andrewcchen/blu64/schematics.pdf

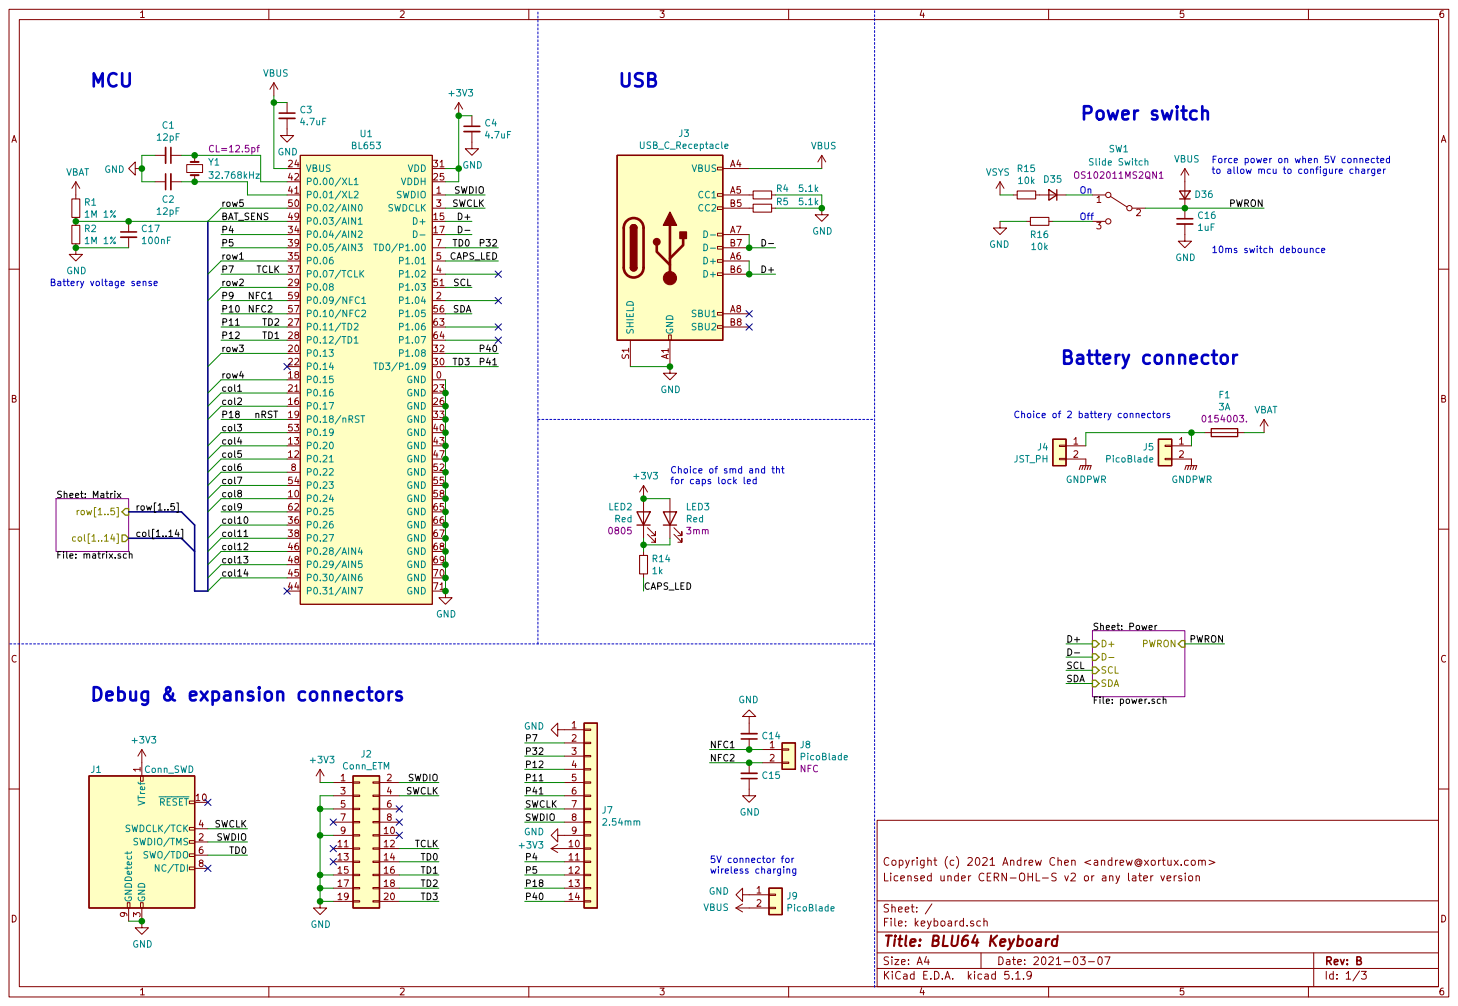
[picture p1: page 1]

to allow mcu to configure charger 10ms switch debounce Power switch

Force power on when 5V connected

SCL SDA
5V connector for wireless charging Choice of smd and tht

for caps lock led

Sheet: Matrix File: matrix.sch
row[1..5]

3 SWDCLK/TCK 4 SWO/TDO 6 NC/TDI 8 GNDDetect 9

Copyright (c) 2021 Andrew Chen <andrew@xortux.com>
File: keyboard.sch Sheet: / Licensed under CERN-OHL-S v2 or any later version

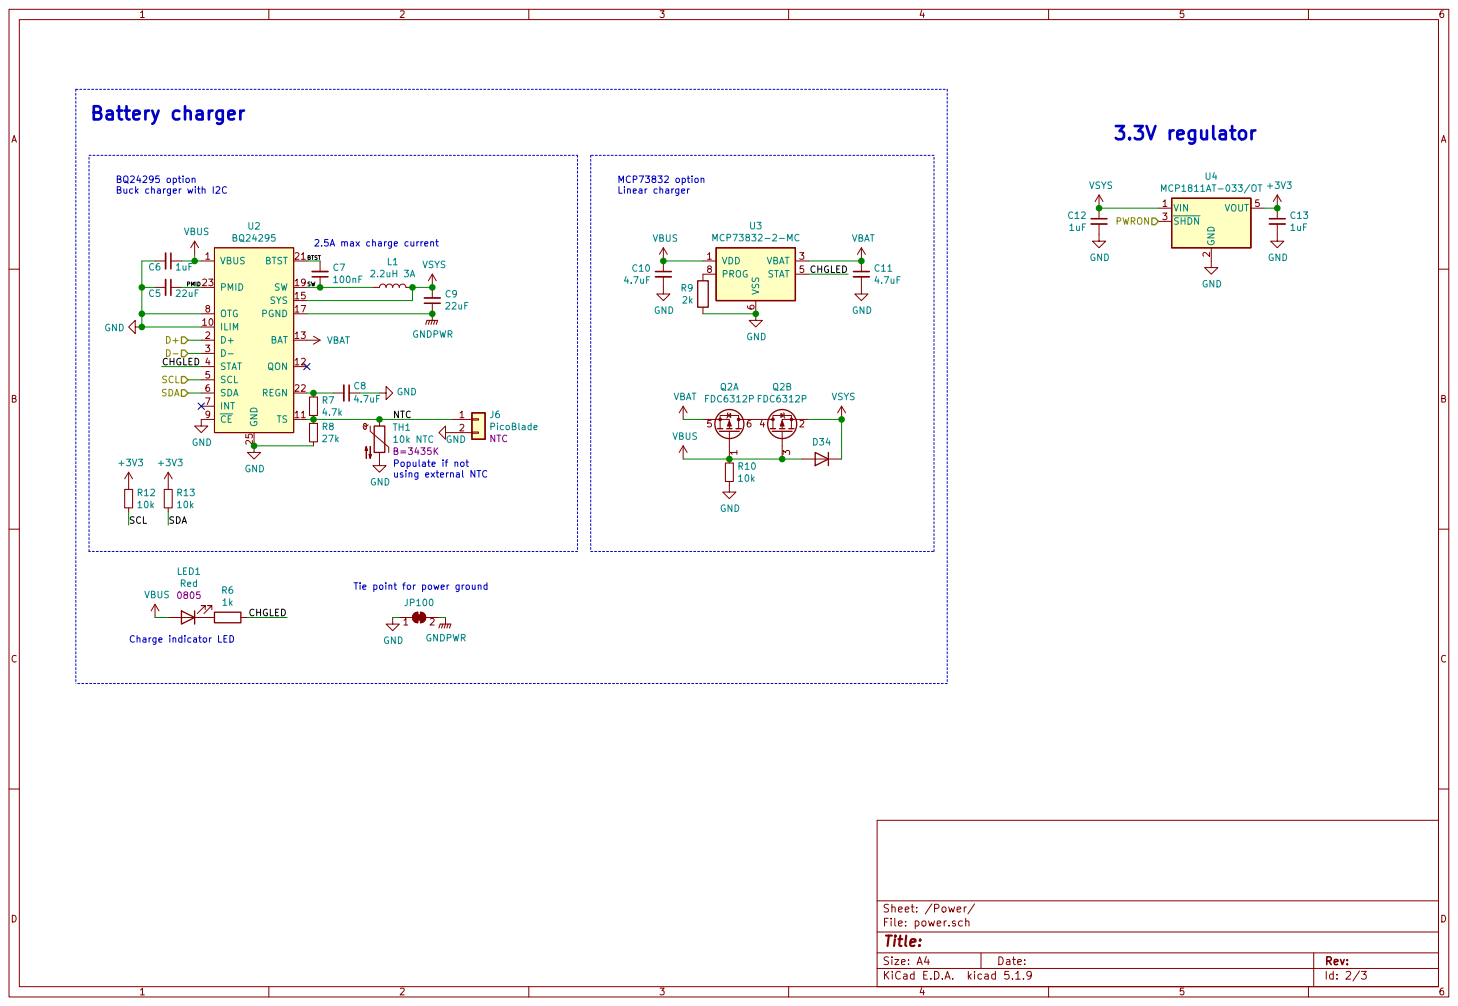
[picture p2: page 2]

Tie point for power ground

File: power.sch Sheet: /Power/
Id: 2/3 Title:

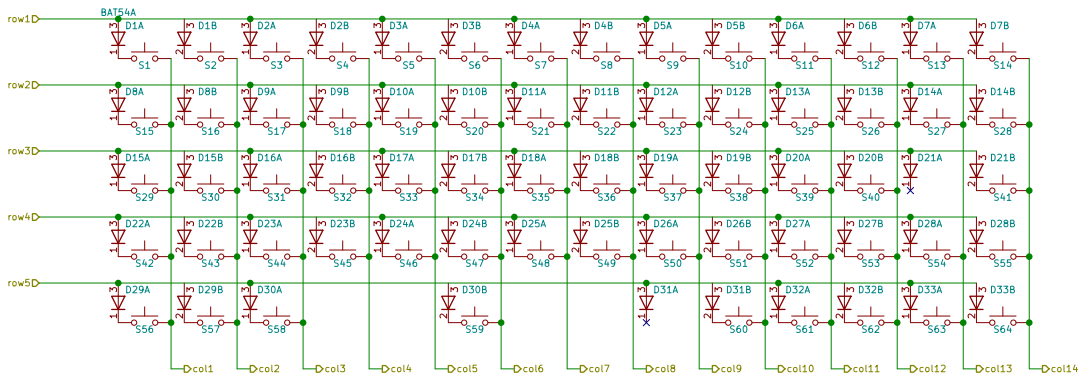
[picture p3: page 3]

Id: 3/3 Title: File: matrix.sch Sheet: /Matrix/
