andrewcchen/blu64/keyboard.kicad_pcb

## KiCad design keyboard.kicad_pcb (2021-03-07)

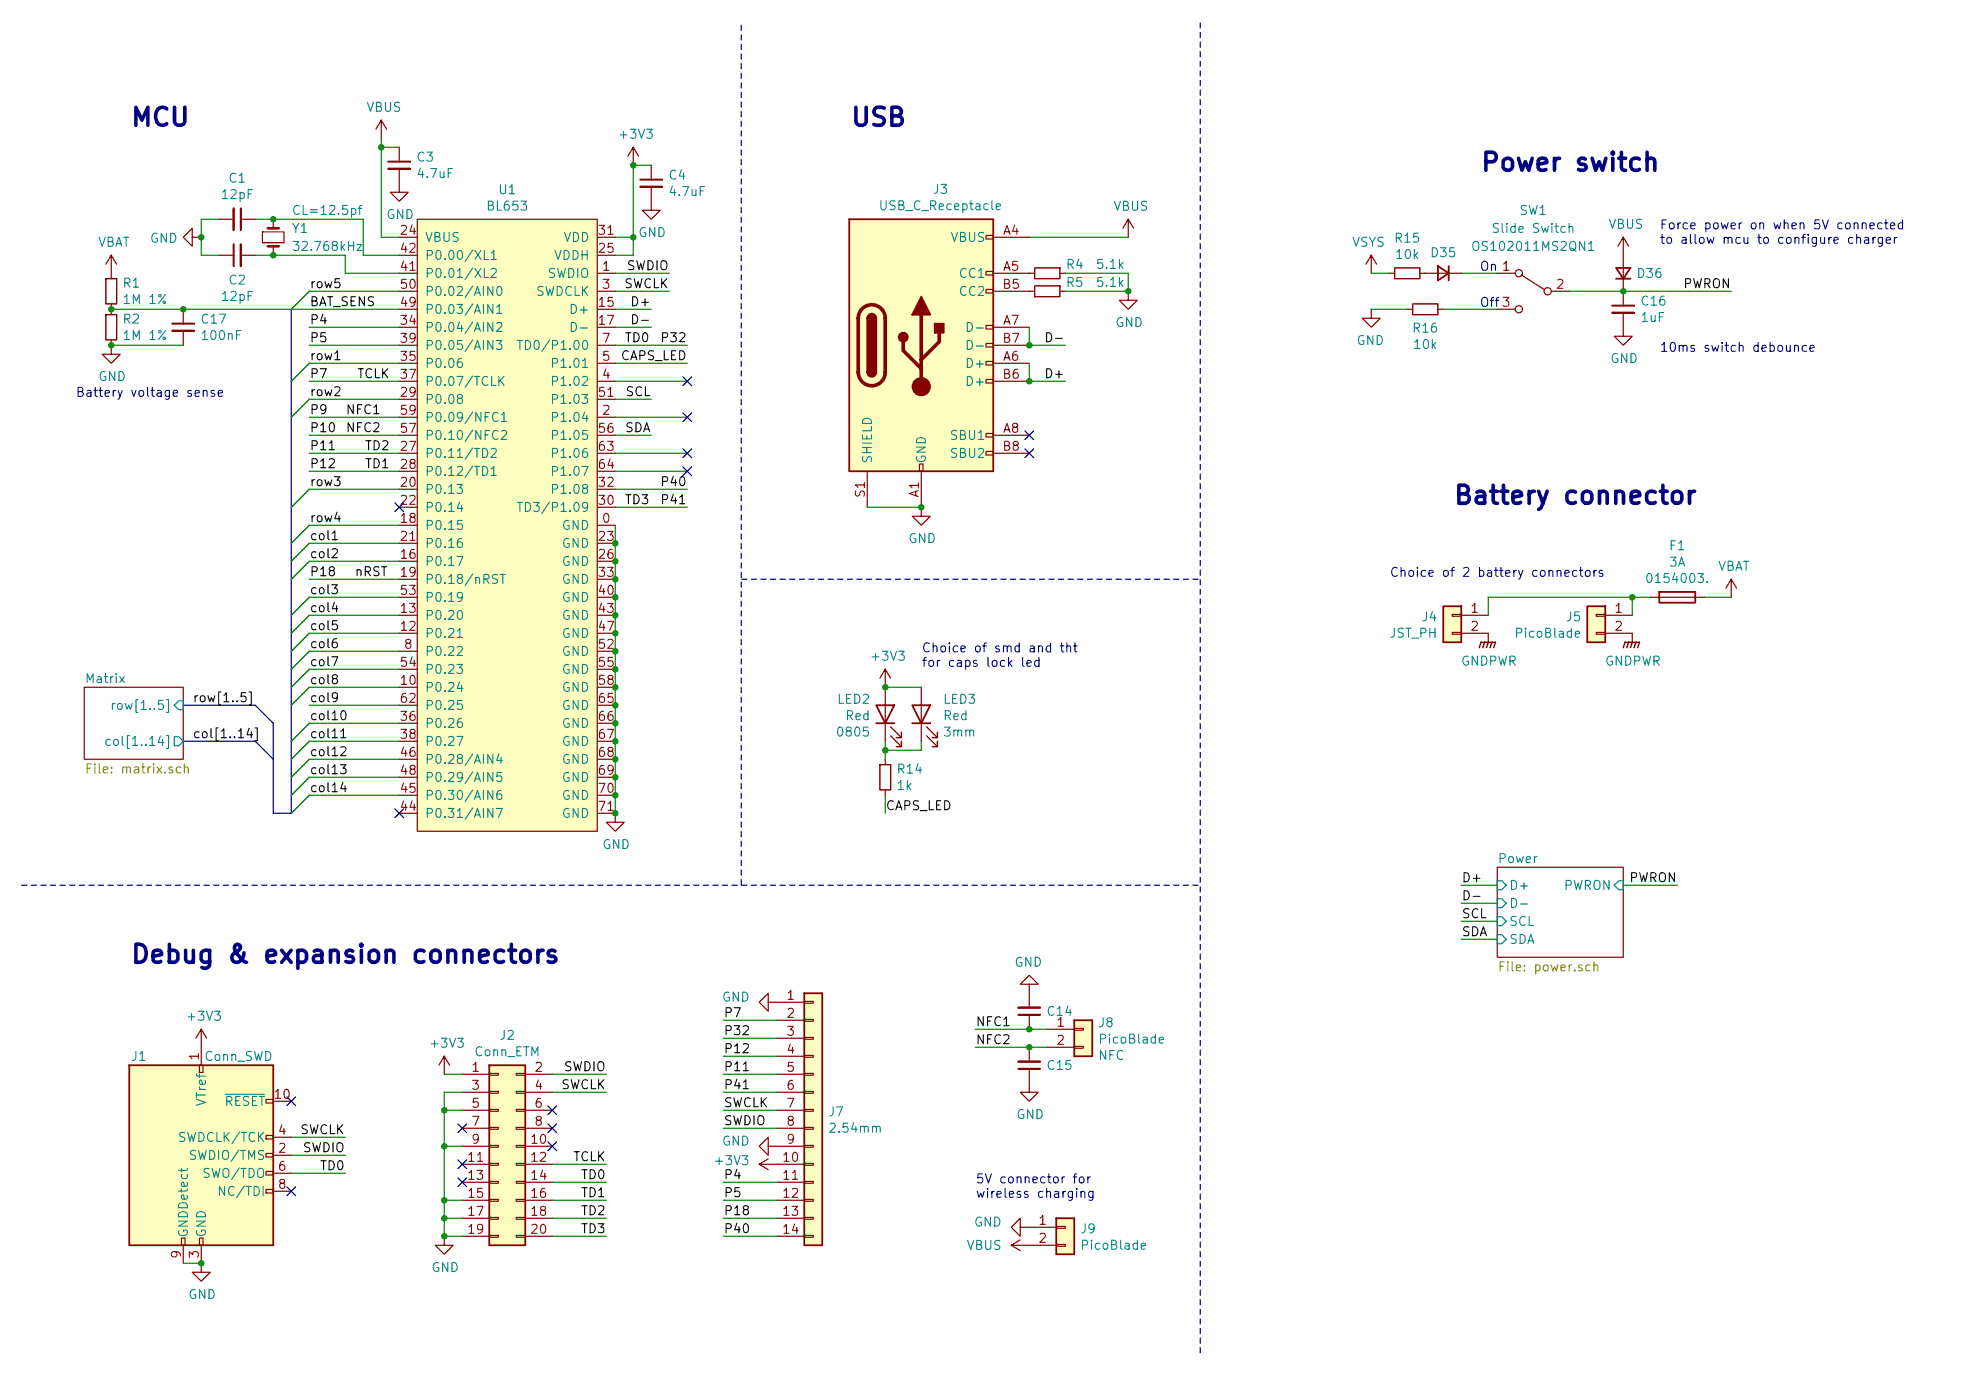
[picture p4: schematic keyboard.sch, BLU64 Keyboard]

Parts:
C1, C2: 12pF; C_0805_2012Metric
C3, C4: 4.7uF; C_0805_2012Metric
C14, C15: Ctune; C_0805_2012Metric
C16: 1uF; C_0805_2012Metric
C17: 100nF; C_0805_2012Metric
D35, D36: 1N4007; D_SOD-123; Part SOD-123 1N4007
F1: 3A; Fuseholder_Littelfuse_Nano2_154x; Part 0154003.
J1: Conn_SWD; PinHeader_2x05_P1.27mm_Vertical_SMD; Part FTSH-105-01-L-DV-K
J2: Conn_ETM; PinHeader_2x10_P1.27mm_Vertical_SMD; Part FTSH-110-01-L-DV-K
J3: USB_C_Receptacle; USB_C_Receptacle_HRO_TYPE-C-31-M-12; Part TYPE-C-31-M-12
J4: JST_PH; JST_PH_S2B-PH-SM4-TB_1x02-1MP_P2.00mm_Horizontal; Part S2B-PH-SM4-TB
J5, J8, J9: PicoBlade; Molex_PicoBlade_53261-0271_1x02-1MP_P1.25mm_Horizontal; Part 53261-0271
J7: 2.54mm; PinHeader_1x14_P2.54mm_Vertical
LED2: Red; LED_0805_2012Metric
LED3: Red; LED_D3.0mm
R1, R2: 1M 1%; R_0805_2012Metric
R4, R5: 5.1k; R_0805_2012Metric
R14: 1k; R_0805_2012Metric
R15, R16: 10k; R_0805_2012Metric
SW1: Slide Switch; SW_OS102011MS2QN1; Part OS102011MS2QN1
U1: BL653; Laird_BL653; Part 453-00039
Y1: 32.768kHz; Crystal_SMD_3215-2Pin_3.2x1.5mm

Connections:
+3V3: C4.1, J1.1 (VTref), J2.1, J7.10, LED2.2 (A), LED3.2 (A), U1.25 (VDDH), U1.31 (VDD); also elsewhere on the board
/BAT_SENS: C17.1, R1.2, R2.1, U1.49 (P0.03/AIN1)
/CAPS_LED: R14.2, U1.5 (P1.01)
/D+: J3.A6 (D+), J3.B6 (D+), U1.15 (D+); also elsewhere on the board
/D-: J3.A7 (D-), J3.B7 (D-), U1.17 (D-); also elsewhere on the board
/NFC1: C14.1, J8.1, U1.59 (P0.09/NFC1)
/NFC2: C15.2, J8.2, U1.57 (P0.10/NFC2)
/P4: J7.11, U1.34 (P0.04/AIN2)
/P5: J7.12, U1.39 (P0.05/AIN3)
/P7: J2.12, J7.2, U1.37 (P0.07/TCLK)
/P11: J2.18, J7.5, U1.27 (P0.11/TD2)
/P12: J2.16, J7.4, U1.28 (P0.12/TD1)
/P18: J7.13, U1.19 (P0.18/nRST)
/P32: J1.6 (SWO/TDO), J2.14, J7.3, U1.7 (TD0/P1.00)
/P40: J7.14, U1.32 (P1.08)
/P41: J2.20, J7.6, U1.30 (TD3/P1.09)
/PWRON: C16.1, D36.1 (K), SW1.2 (B); also elsewhere on the board
/SCL: U1.51 (P1.03); also elsewhere on the board
/SDA: U1.56 (P1.05); also elsewhere on the board
/SWCLK: J1.4 (SWDCLK/TCK), J2.4, J7.7, U1.3 (SWDCLK)
/SWDIO: J1.2 (SWDIO/TMS), J2.2, J7.8, U1.1 (SWDIO)
/col1: U1.21 (P0.16); also elsewhere on the board
/col2: U1.16 (P0.17); also elsewhere on the board
/col3: U1.53 (P0.19); also elsewhere on the board
/col4: U1.13 (P0.20); also elsewhere on the board
/col5: U1.12 (P0.21); also elsewhere on the board
/col6: U1.8 (P0.22); also elsewhere on the board
/col7: U1.54 (P0.23); also elsewhere on the board
/col8: U1.10 (P0.24); also elsewhere on the board
/col9: U1.62 (P0.25); also elsewhere on the board
/col10: U1.36 (P0.26); also elsewhere on the board
/col11: U1.38 (P0.27); also elsewhere on the board
/col12: U1.46 (P0.28/AIN4); also elsewhere on the board
/col13: U1.48 (P0.29/AIN5); also elsewhere on the board
/col14: U1.45 (P0.30/AIN6); also elsewhere on the board
/row1: U1.35 (P0.06); also elsewhere on the board
/row2: U1.29 (P0.08); also elsewhere on the board
/row3: U1.20 (P0.13); also elsewhere on the board
/row4: U1.18 (P0.15); also elsewhere on the board
/row5: U1.50 (P0.02/AIN0); also elsewhere on the board
GND: C1.2, C2.1, C3.2, C4.2, C14.2, C15.1, C16.2, C17.2, J1.3 (GND), J1.5 (GND), J1.9 (GNDDetect), J2.3, J2.5, J2.9, J2.15, J2.17, J2.19, J3.A1 (GND), J3.A12 (GND), J3.B1 (GND), J3.B12 (GND), J3.S1 (SHIELD), J7.1, J7.9, J9.1, R2.2, R4.1, R5.1, R16.1, U1.0 (GND), U1.23 (GND), U1.26 (GND), U1.33 (GND), U1.40 (GND), U1.43 (GND), U1.47 (GND), U1.52 (GND), U1.55 (GND), U1.58 (GND), U1.65 (GND), U1.66 (GND), U1.67 (GND), U1.68 (GND), U1.69 (GND), U1.70 (GND), U1.71 (GND); also elsewhere on the board
GNDPWR: J4.2, J5.2; also elsewhere on the board
unnamed: C1.1, U1.42 (P0.00/XL1), Y1.1
unnamed: C2.2, U1.41 (P0.01/XL2), Y1.2
unnamed: D35.1 (K), SW1.1 (A)
unnamed: D35.2 (A), R15.2
unnamed: F1.2, J4.1, J5.1
unnamed: J3.A5 (CC1), R4.2
unnamed: J3.B5 (CC2), R5.2
unnamed: LED2.1 (K), LED3.1 (K), R14.1
unnamed: R16.2, SW1.3 (C)
VBAT: F1.1, R1.1; also elsewhere on the board
VBUS: C3.1, D36.2 (A), J3.A4 (VBUS), J3.A9 (VBUS), J3.B4 (VBUS), J3.B9 (VBUS), J9.2, U1.24 (VBUS); also elsewhere on the board
VSYS: R15.1; also elsewhere on the board

Notes on the sheet:
MCU
Debug & expansion connectors
USB
5V connector for wireless charging
Battery voltage sense
Choice of smd and tht for caps lock led
Force power on when 5V connected to allow mcu to configure charger
10ms switch debounce
Off
Choice of 2 battery connectors
Power switch
Battery connector

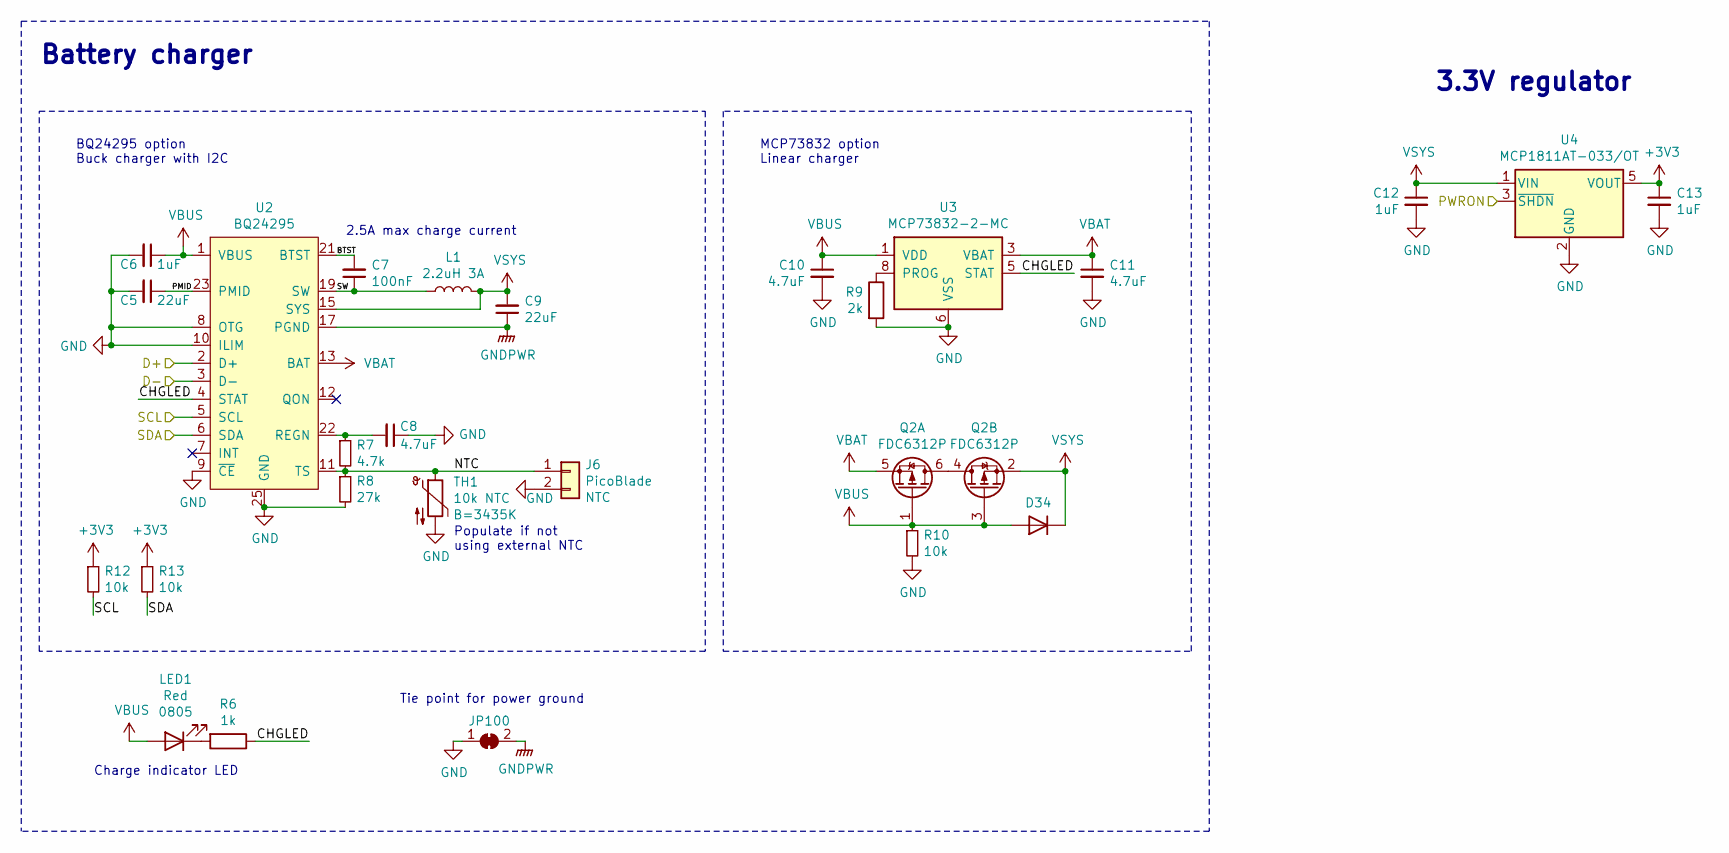
[picture p5: schematic power.sch]

Parts:
C5, C12, C13: 1uF; C_0805_2012Metric
C6, C9: 22uF; C_1206_3216Metric
C7: 100nF; C_0805_2012Metric
C8, C10, C11: 4.7uF; C_0805_2012Metric
D34: 1N4007; D_SOD-123; Part SOD-123 1N4007
J6: PicoBlade; Molex_PicoBlade_53261-0271_1x02-1MP_P1.25mm_Horizontal; Part 53261-0271
JP100: Jumper_2_Bridged; GND_Tie
L1: 2.2uH 3A; L_Bourns-SRN4018; Part BCIHP0420TB-2R2M
LED1: Red; LED_0805_2012Metric
Q2: FDC6312P; SuperSOT-6; Part FDC6312P
R6: 1k; R_0805_2012Metric
R7: 4.7k; R_0805_2012Metric
R8: 27k; R_0805_2012Metric
R9: 2k; R_0805_2012Metric
R10, R12, R13: 10k; R_0805_2012Metric
TH1: 10k NTC; R_0805_2012Metric
U2: BQ24295; QFN-24-1EP_4x4mm_P0.5mm_EP2.65x2.65mm; Part BQ24295
U3: MCP73832-2-MC; DFN-8-1EP_3x2mm_P0.5mm_EP1.7x1.4mm; Part MCP73832-2ACI/MC
U4: MCP1811AT-033/OT; SOT-23-5; Part MCP1811AT-033/OT

Connections:
+3V3: C13.1, R12.1, R13.1, U4.5 (VOUT); also elsewhere on the board
/D+: U2.2 (D+); also elsewhere on the board
/D-: U2.3 (D-); also elsewhere on the board
/PWRON: U4.3 (~SHDN); also elsewhere on the board
/Power/BTST: C7.2, U2.21 (BTST)
/Power/CHGLED: R6.1, U2.4 (STAT), U3.5 (STAT)
/Power/NTC: J6.1, R7.2, R8.1, TH1.1, U2.11 (TS)
/Power/PMID: C6.1, U2.23 (PMID)
/Power/SW: C7.1, L1.1, U2.19 (SW), U2.20 (SW)
/SCL: R12.2, U2.5 (SCL); also elsewhere on the board
/SDA: R13.2, U2.6 (SDA); also elsewhere on the board
GND: C5.2, C6.2, C8.1, C10.2, C11.2, C12.2, C13.2, J6.2, JP100.1 (A), R8.2, R9.2, R10.2, TH1.2, U2.8 (OTG), U2.9 (~CE), U2.10 (ILIM), U2.25 (GND), U3.6 (VSS), U3.9 (VSS), U4.2 (GND); also elsewhere on the board
GNDPWR: C9.1, JP100.2 (B), U2.17 (PGND), U2.18 (PGND); also elsewhere on the board
unnamed: C8.2, R7.1, U2.22 (REGN)
unnamed: LED1.1 (K), R6.2
unnamed: Q2.4 (D), Q2.6 (D)
unnamed: R9.1, U3.8 (PROG)
VBAT: C11.1, Q2.5 (S), U2.13 (BAT), U2.14 (BAT), U3.3 (VBAT), U3.4 (VBAT); also elsewhere on the board
VBUS: C5.1, C10.1, D34.2 (A), LED1.2 (A), Q2.1 (G), Q2.3 (G), R10.1, U2.1 (VBUS), U2.24 (VBUS), U3.1 (VDD), U3.2 (VDD); also elsewhere on the board
VSYS: C9.2, C12.1, D34.1 (K), L1.2, Q2.2 (S), U2.15 (SYS), U2.16 (SYS), U4.1 (VIN); also elsewhere on the board

Notes on the sheet:
2.5A max charge current
Populate if not using external NTC
BQ24295 option Buck charger with I2C
MCP73832 option Linear charger
Charge indicator LED
Battery charger
Tie point for power ground
3.3V regulator

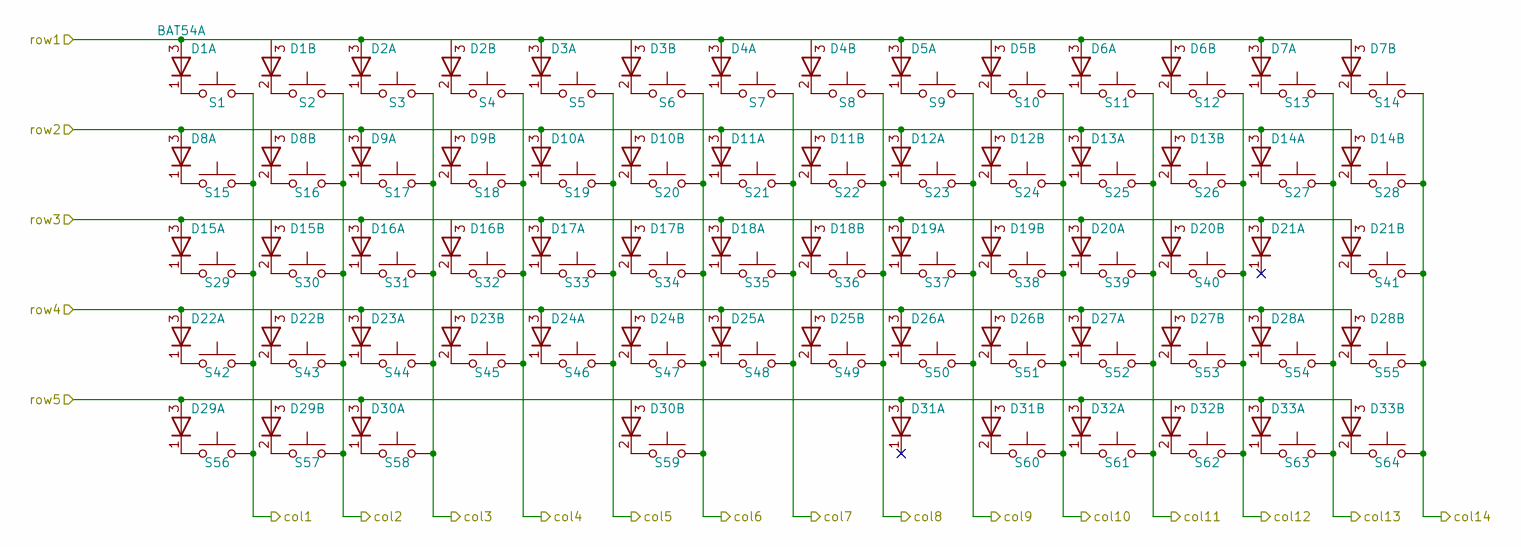
[picture p6: schematic matrix.sch]

Parts:
D1, D2, D3, D4, D5, D6, D7, D8, D9, D10, D11, D12, D13, D14, D15, D16, D17, D18, D19, D20, D21, D22, D23, D24, D25, D26, D27, D28, D29, D30, D31, D32, D33: BAT54A; SOT-23; Part BAT54A
S1, S2, S3, S4, S5, S6, S7, S8, S9, S10, S11, S12, S13, S16, S17, S18, S19, S20, S21, S22, S23, S24, S25, S26, S27, S30, S31, S32, S33, S34, S35, S36, S37, S38, S39, S40, S43, S44, S45, S46, S47, S48, S49, S50, S51, S52, S53, S54, S55, S60, S61, S62, S63, S64: MX1A; SW_Cherry_MX_1.00u_PCB
S14, S42: MX1A; SW_Cherry_MX_2.00u_PCB
S15, S28: MX1A; SW_Cherry_MX_1.50u_PCB
S29: MX1A; SW_Cherry_MX_1.75u_PCB
S41: MX1A; SW_Cherry_MX_2.25u_PCB
S56, S57, S58: MX1A; SW_Cherry_MX_1.25u_PCB
S59: MX1A; SW_Cherry_MX_6.25u_PCB

Connections:
/col1: S1.2, S15.2, S29.2, S42.2, S56.2; also elsewhere on the board
/col2: S2.2, S16.2, S30.2, S43.2, S57.2; also elsewhere on the board
/col3: S3.2, S17.2, S31.2, S44.2, S58.2; also elsewhere on the board
/col4: S4.2, S18.2, S32.2, S45.2; also elsewhere on the board
/col5: S5.2, S19.2, S33.2, S46.2; also elsewhere on the board
/col6: S6.2, S20.2, S34.2, S47.2, S59.2; also elsewhere on the board
/col7: S7.2, S21.2, S35.2, S48.2; also elsewhere on the board
/col8: S8.2, S22.2, S36.2, S49.2; also elsewhere on the board
/col9: S9.2, S23.2, S37.2, S50.2; also elsewhere on the board
/col10: S10.2, S24.2, S38.2, S51.2, S60.2; also elsewhere on the board
/col11: S11.2, S25.2, S39.2, S52.2, S61.2; also elsewhere on the board
/col12: S12.2, S26.2, S40.2, S53.2, S62.2; also elsewhere on the board
/col13: S13.2, S27.2, S54.2, S63.2; also elsewhere on the board
/col14: S14.2, S28.2, S41.2, S55.2, S64.2; also elsewhere on the board
/row1: D1.3 (A), D2.3 (A), D3.3 (A), D4.3 (A), D5.3 (A), D6.3 (A), D7.3 (A); also elsewhere on the board
/row2: D8.3 (A), D9.3 (A), D10.3 (A), D11.3 (A), D12.3 (A), D13.3 (A), D14.3 (A); also elsewhere on the board
/row3: D15.3 (A), D16.3 (A), D17.3 (A), D18.3 (A), D19.3 (A), D20.3 (A), D21.3 (A); also elsewhere on the board
/row4: D22.3 (A), D23.3 (A), D24.3 (A), D25.3 (A), D26.3 (A), D27.3 (A), D28.3 (A); also elsewhere on the board
/row5: D29.3 (A), D30.3 (A), D31.3 (A), D32.3 (A), D33.3 (A); also elsewhere on the board
unnamed: D1.1 (K), S1.1
unnamed: D1.2 (K), S2.1
unnamed: D2.1 (K), S3.1
unnamed: D2.2 (K), S4.1
unnamed: D3.1 (K), S5.1
unnamed: D3.2 (K), S6.1
unnamed: D4.1 (K), S7.1
unnamed: D4.2 (K), S8.1
unnamed: D5.1 (K), S9.1
unnamed: D5.2 (K), S10.1
unnamed: D6.1 (K), S11.1
unnamed: D6.2 (K), S12.1
unnamed: D7.1 (K), S13.1
unnamed: D7.2 (K), S14.1
unnamed: D8.1 (K), S15.1
unnamed: D8.2 (K), S16.1
unnamed: D9.1 (K), S17.1
unnamed: D9.2 (K), S18.1
unnamed: D10.1 (K), S19.1
unnamed: D10.2 (K), S20.1
unnamed: D11.1 (K), S21.1
unnamed: D11.2 (K), S22.1
unnamed: D12.1 (K), S23.1
unnamed: D12.2 (K), S24.1
unnamed: D13.1 (K), S25.1
unnamed: D13.2 (K), S26.1
unnamed: D14.1 (K), S27.1
unnamed: D14.2 (K), S28.1
unnamed: D15.1 (K), S29.1
unnamed: D15.2 (K), S30.1
unnamed: D16.1 (K), S31.1
unnamed: D16.2 (K), S32.1
unnamed: D17.1 (K), S33.1
unnamed: D17.2 (K), S34.1
unnamed: D18.1 (K), S35.1
unnamed: D18.2 (K), S36.1
unnamed: D19.1 (K), S37.1
unnamed: D19.2 (K), S38.1
unnamed: D20.1 (K), S39.1
unnamed: D20.2 (K), S40.1
unnamed: D21.2 (K), S41.1
unnamed: D22.1 (K), S42.1
unnamed: D22.2 (K), S43.1
unnamed: D23.1 (K), S44.1
unnamed: D23.2 (K), S45.1
unnamed: D24.1 (K), S46.1
unnamed: D24.2 (K), S47.1
unnamed: D25.1 (K), S48.1
unnamed: D25.2 (K), S49.1
unnamed: D26.1 (K), S50.1
unnamed: D26.2 (K), S51.1
unnamed: D27.1 (K), S52.1
unnamed: D27.2 (K), S53.1
unnamed: D28.1 (K), S54.1
unnamed: D28.2 (K), S55.1
unnamed: D29.1 (K), S56.1
unnamed: D29.2 (K), S57.1
unnamed: D30.1 (K), S58.1
unnamed: D30.2 (K), S59.1
unnamed: D31.2 (K), S60.1
unnamed: D32.1 (K), S61.1
unnamed: D32.2 (K), S62.1
unnamed: D33.1 (K), S63.1
unnamed: D33.2 (K), S64.1

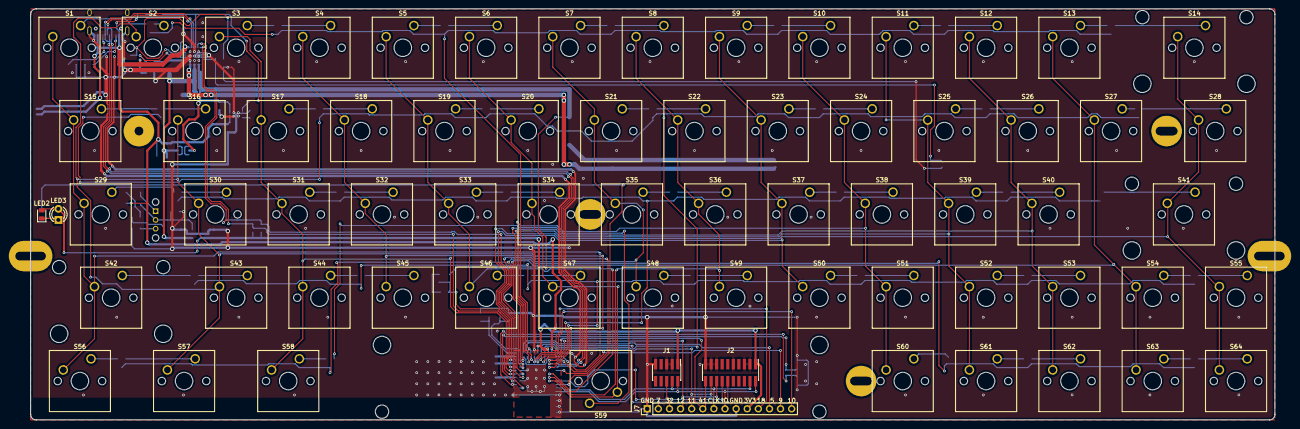
[picture p7: board keyboard.kicad_pcb from above]

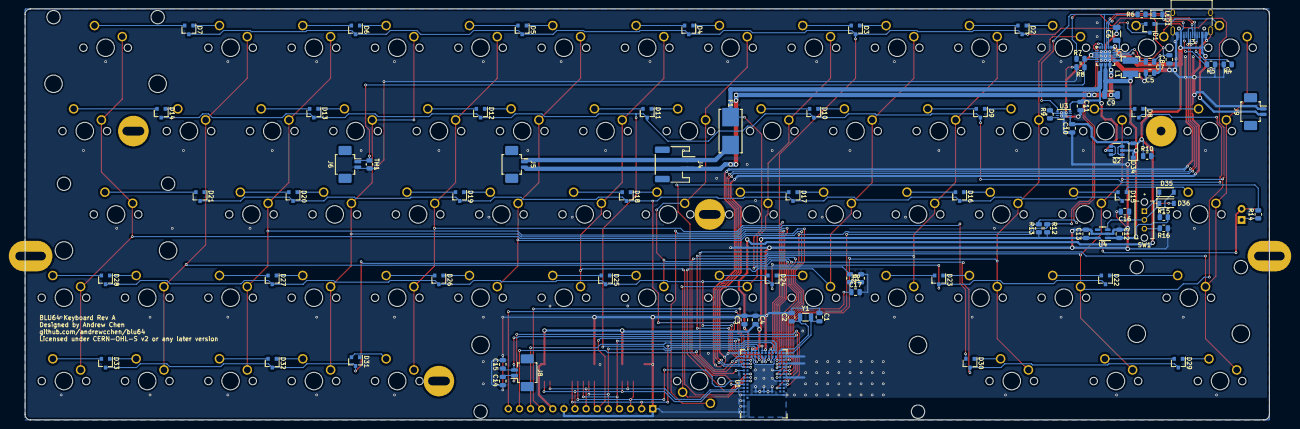
[picture p8: board keyboard.kicad_pcb from below]

Board: 2 copper layers, 284.5 x 94.0 mm, 160 parts (85 on the bottom side), 127 nets.

Other parts of the board:
MK1: Hole_1
MK2, MK3, MK6: Hole_2
MK4, MK5: Hole_3
