andrewcchen/blu64/(commit log)

2021-02-03 power routed
    [keyboard.kicad_pcb, keyboard.sch, matrix.sch, power.sch]
2021-02-03 all routed
    [keyboard.kicad_pcb, keyboard.sch]
2021-02-03 almost ready rev a
    [keyboard.kicad_pcb, matrix.sch, power.sch]
2021-02-04 improve power switch circuit
    [keyboard.kicad_pcb, keyboard.sch, power.sch]
2021-02-04 final changes to power switch circuitry
    [keyboard.kicad_pcb, keyboard.sch]
2021-02-05 Rev A complete
    [keyboard-B_Cu.gbr, keyboard-B_Mask.gbr, keyboard-B_Paste.gbr, keyboard-B_SilkS.gbr, keyboard-Edge_Cuts.gbr, keyboard-F_Cu.gbr, keyboard-F_Mask.gbr, keyboard-F_Paste.gbr]
2021-02-14 Change diode part BAS70 -> BAT54
    Use lower voltage diode for better forward voltage
    [keyboard.kicad_pcb, keyboard.sch, matrix.sch]
2021-02-23 prettyify schematics a little
    [keyboard.sch, power.sch]
2021-02-24 oops switch on wrong side of board
    only affects silkscreen
    [keyboard-B_Cu.gbr, keyboard-B_Mask.gbr, keyboard-B_Paste.gbr, keyboard-B_SilkS.gbr, keyboard-Edge_Cuts.gbr, keyboard-F_Cu.gbr, keyboard-F_Mask.gbr, keyboard-F_Paste.gbr]
2021-03-07 Fix battery sense quiescent current draw
    Q1 was useless because current still sinks through the mcu's esd diodes
    [keyboard-B_Cu.gbr, keyboard-B_Mask.gbr, keyboard-B_Paste.gbr, keyboard-B_SilkS.gbr, keyboard-Edge_Cuts.gbr, keyboard-F_Cu.gbr, keyboard-F_Mask.gbr, keyboard-F_Paste.gbr]
2021-03-07 archive footprints and schematics symbols
    [keyboard.kicad_pcb, keyboard.sch, matrix.sch, power.sch]
2021-03-07 small change to expansion header pinout
    [keyboard.kicad_pcb, keyboard.sch]
